keinerobles/Amplificador-multi-etapas-con-transistores-BJT/Prueba etapa 1.jpeg

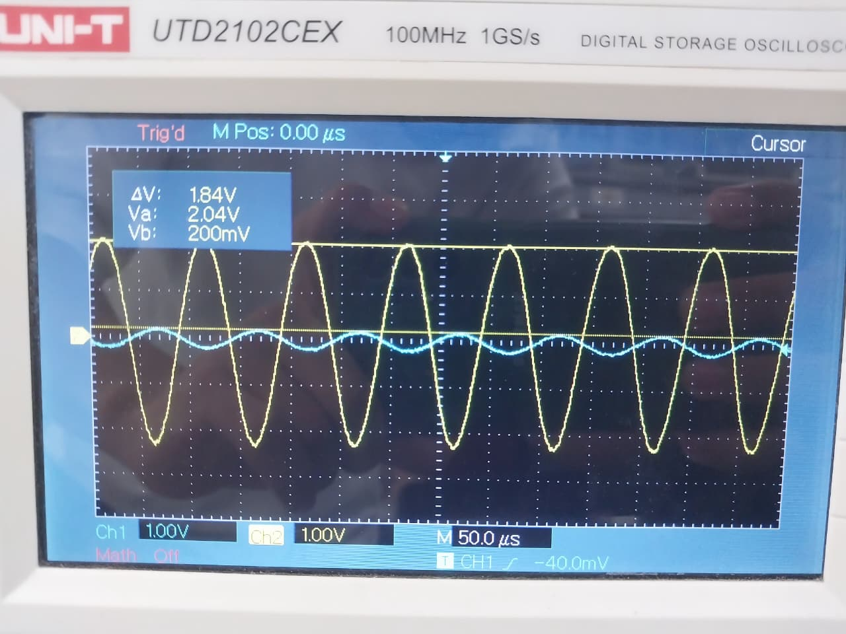
Prueba etapa 1.jpeg
