keinerobles/Amplificador-multi-etapas-con-transistores-BJT/render PCB.jpeg

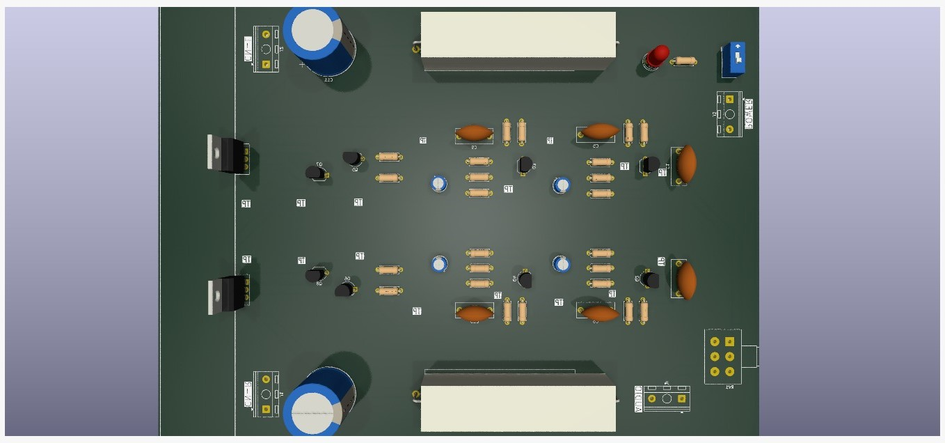
render PCB.jpeg
