keinerobles/Amplificador-multi-etapas-con-transistores-BJT/README.md

# Amplificador-multi-etapas-con-transistores-BJT
