keinerobles/Amplificador-multi-etapas-con-transistores-BJT/costos por canal ( Canal A).pdf

## Bill Of Materials for proyecto_ampli_mutl

Design Title | proyecto_ampli_mutl

### Author Document Number Revision

Design Created | miércoles, 11 de marzo de 2026
Design Last Modified miércoles, 11 de marzo de 2026

### Total Parts In Design 28

0 Modules
Quantity | References | Value | Stock Code | Unit Cost
Sub-totals: | | | | €0,00
4 Capacitors
Quantity | References | Value | Stock Code | Unit Cost
1 | C1 | 100nF | | €300,00
1 | C2 | 25.8nF | | €300,00
1 | C3 | 10nF | | €300,00
1 | C4 | 470uF | | €3.000,00
Sub-totals: | | | | €3.900,00
8 Resistors
Quantity | References | Value | Stock Code | Unit Cost
1 | R1 | 2.2k | | €150,00
2 | R2,R1-2 | 33k | | €150,00
1 | R47 | 150 | | €150,00
1 | R48 | 38k | | €150,00
1 | R1-3 | 1M | | €150,00
1 | R2-2 | 220k | | €150,00
1 | R2-3 | 150k | | €150,00
Sub-totals: | | | | €1.200,00
0 Integrated Circuits
Quantity | References | Value | Stock Code | Unit Cost
Sub-totals: | | | | €0,00
5 Transistors
Quantity | References | Value | Stock Code | Unit Cost
2 | Q1-Q2 | BC547 | | €500,00
2 | Q3-Q4 | 2N3904 | | €600,00
1 | Q5 | TIP41 | | €1.500,00
Sub-totals: | | | | €3.700,00
0 Diodes
Quantity | References | Value | Stock Code | Unit Cost
Sub-totals: | | | | €0,00
11 Miscellaneous
Quantity | References | Value | Stock Code | Unit Cost
1 | CE1 | 10uF | | €500,00
1 | CE2 | 2.2uF | | €500,00
2 | RC,RE2-2 | 1.8k | | €150,00
1 | RC2 | 12k | | €150,00
1 | RE1 | 82 | | €150,00
1 | RE2 | 2.2k | | €150,00
1 | RE-3 | 20 | | €100,00
1 | RE1-2 | 470 | | €150,00
1 | RL | 8 | | €100,00
1 | RV3 | 20k | | €150,00
Sub-totals: | | | | €2.250,00

Tot

als: | €
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
| 2 de
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
