keinerobles/Amplificador-multi-etapas-con-transistores-BJT/fase puebas etapa 1.jpeg

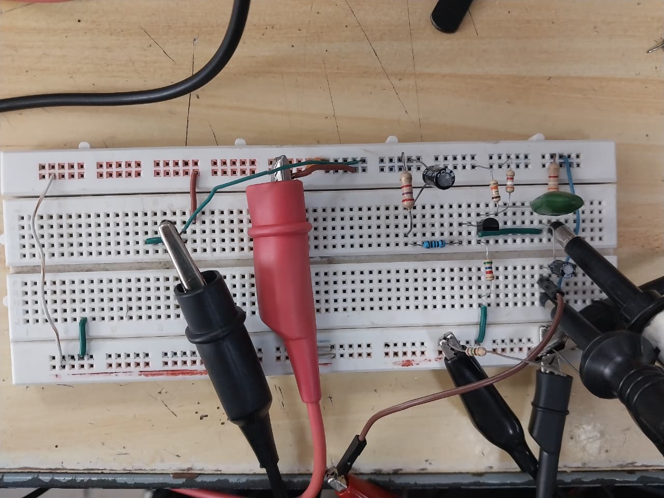
fase puebas etapa 1.jpeg
