keinerobles/Amplificador-multi-etapas-con-transistores-BJT/Render PCB fuente.jpeg

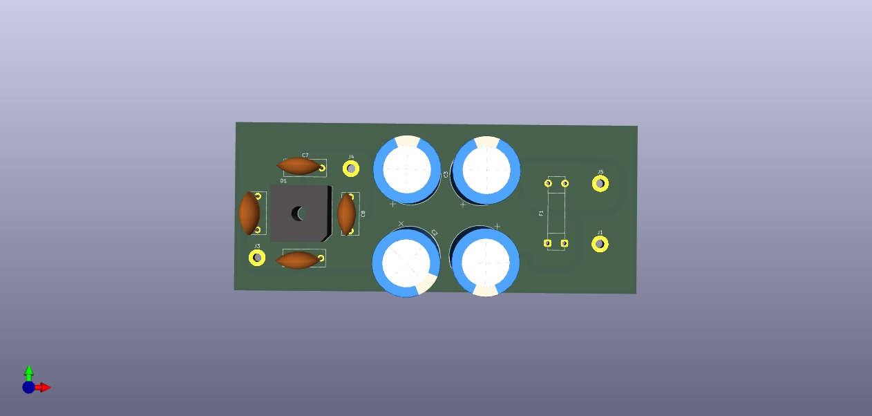
Render PCB fuente.jpeg
