keinerobles/Amplificador-multi-etapas-con-transistores-BJT/salida amplificador 2.pdf

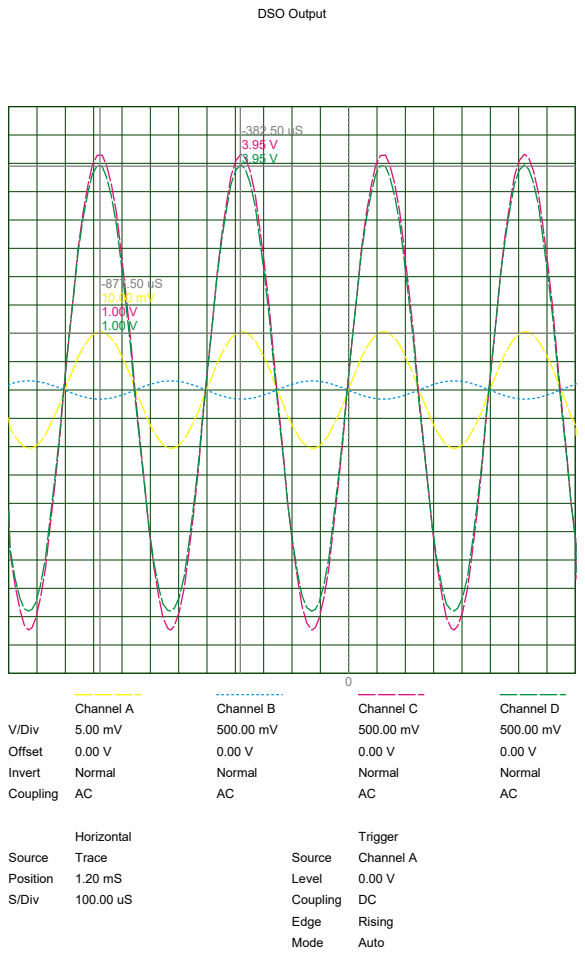
[picture p21: page 1]
DSO Output; V/Div; Offset; Invert; Coupling; Channel A; Normal; Channel B; Channel C; Channel D; Horizontal; Source; Position; S/Div; Trace; Trigger; Level; Edge; Mode; Rising; Auto

-382.50 uS
3.95 V
