keinerobles/Amplificador-multi-etapas-con-transistores-BJT/salida amplificador version final.pdf

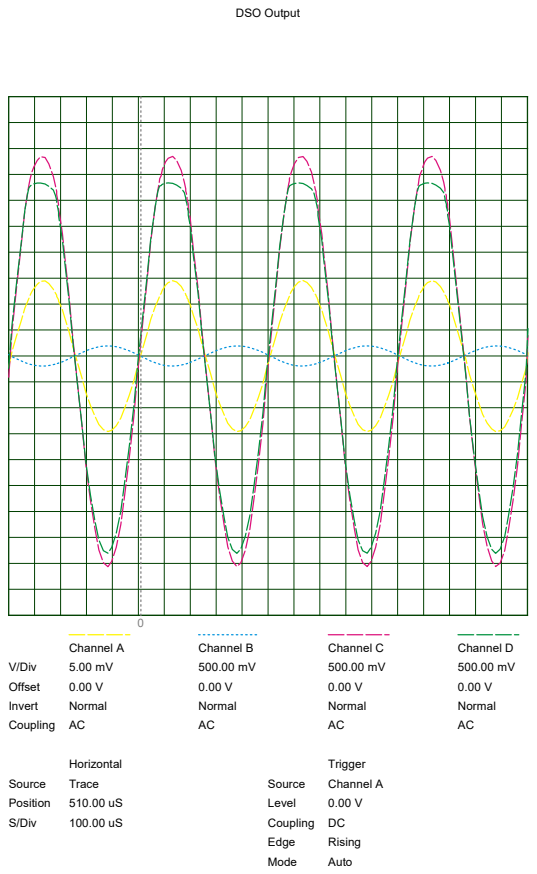
[picture p22: page 1]
DSO Output; V/Div Offset Invert Coupling; Channel A 5.00 mV 0.00 V Normal AC; Channel B 500.00 mV 0.00 V Normal AC; Channel C 500.00 mV 0.00 V Normal AC; Channel D 500.00 mV 0.00 V Normal AC; Horizontal; Source Position S/Div; Trace 510.00 uS 100.00 uS; Trigger; Source Level Coupling Edge Mode; Channel A 0.00 V DC Rising Auto
