keinerobles/Amplificador-multi-etapas-con-transistores-BJT/salida amplificador.pdf

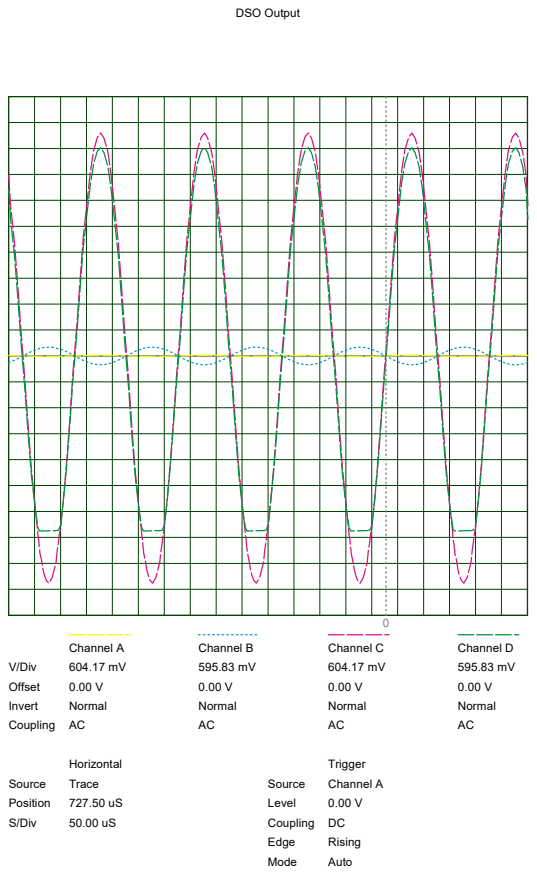
[picture p23: page 1]
DSO Output; V/Div Offset Invert Coupling; Channel A 604.17 mV 0.00 V Normal AC; Channel B 595.83 mV 0.00 V Normal AC; Channel C 604.17 mV 0.00 V Normal AC; Channel D 595.83 mV 0.00 V Normal AC; Horizontal; Source Position S/Div; Trace 727.50 uS 50.00 uS; Trigger; Source Level Coupling Edge Mode; Channel A 0.00 V DC Rising Auto
