keinerobles/Amplificador-multi-etapas-con-transistores-BJT/salida audio amplificador version final.pdf

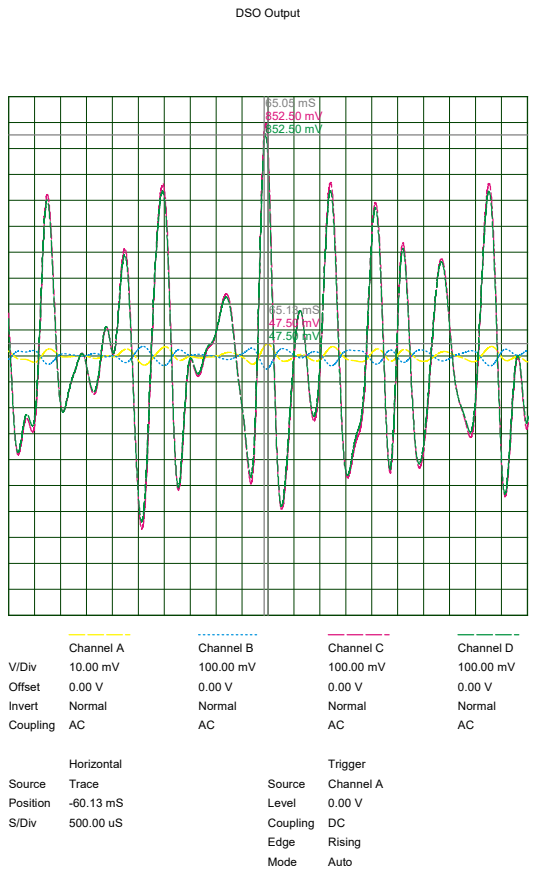
[picture p24: page 1]
DSO Output; V/Div Offset Invert Coupling; Channel A 10.00 mV 0.00 V Normal AC; Channel B 100.00 mV 0.00 V Normal AC; Channel C 100.00 mV 0.00 V Normal AC; Channel D 100.00 mV 0.00 V Normal AC; Horizontal; Source Position S/Div; Trace -60.13 mS 500.00 uS; Trigger; Source Level Coupling Edge Mode; Channel A 0.00 V DC Rising Auto
