keinerobles/Amplificador-multi-etapas-con-transistores-BJT/(list of files, drawings)

Other design files:
estapas_1y2pdsprj.pdsprj
proyecto_ampli_mutl.pdsprj
